eshazen/epic-control-panel/README.md

# epic-control-panel

Simple programmable controller for various applications in EPIC

KiCAD PCB design copied from SCOS project for BME research.

Applications:

* Wind tunnel controller for probe angle/height
