eshazen/epic-control-panel/Software/control-panel-blinky/README.md

# Keyboard / display / LED test

Test keyboard, display, LEDs
