eshazen/epic-control-panel/KiCAD/control-panel/3D/switch.step

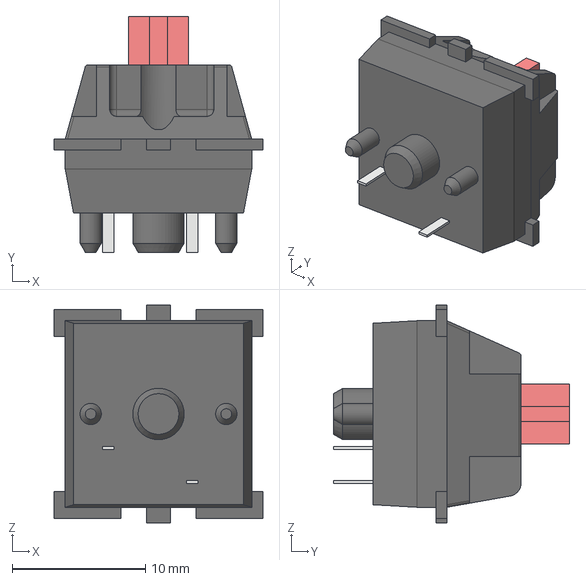
[picture p1: CAD file, 2024-07-23]
KiCAD/control-panel/3D/switch.step
15.6 x 17.7 x 16.3 mm
