eshazen/epic-control-panel/KiCAD/control-panel/control-panel.step

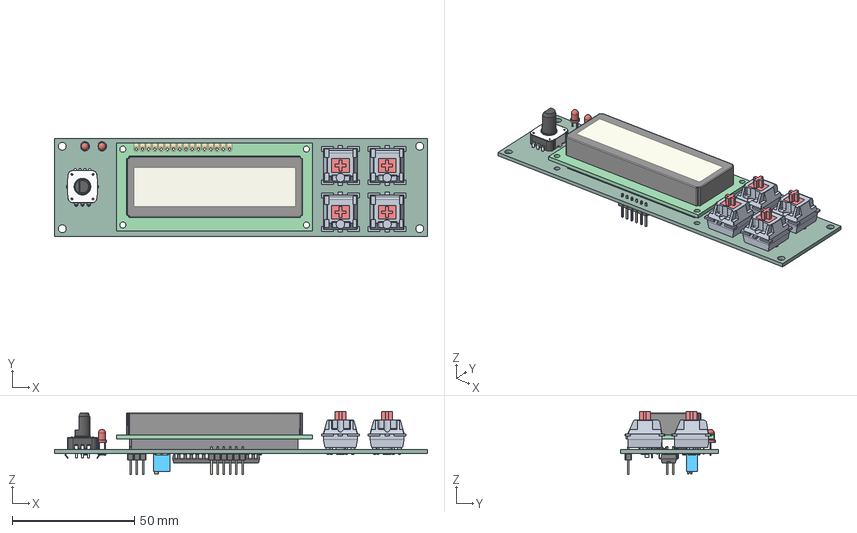
[picture p2: CAD file, 2024-07-25]
KiCAD/control-panel/control-panel.step
152.4 x 40.0 x 25.9 mm
cherry mx v28 x 4
EC12_10mm (3)
LED_D3.0mm x 2
Pad_001_sp
Potentiometer_Bourns_3266W_Vertical
R_1206_3216Metric x 6
PinHeader_1x06_P254mm_Vertical
PinHeader_2x03_P254mm_Vertical
C_1206_3216Metric
DIP-28_W7.62mm
control-panel_PCB
