eshazen/epic-control-panel/WindTunnel/Case/front_panel.dxf

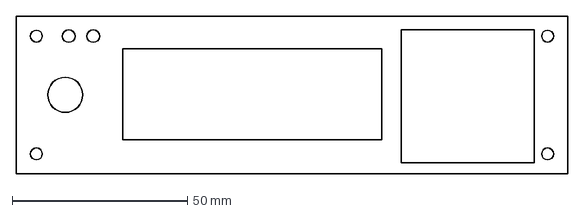
[picture p3: CAD file, 2024-07-25]
WindTunnel/Case/front_panel.dxf
157.4 x 45.0 mm
