eshazen/epic-control-panel/KiCAD/control-panel/3D/EC12 Encoder 10mm 3pin.stp

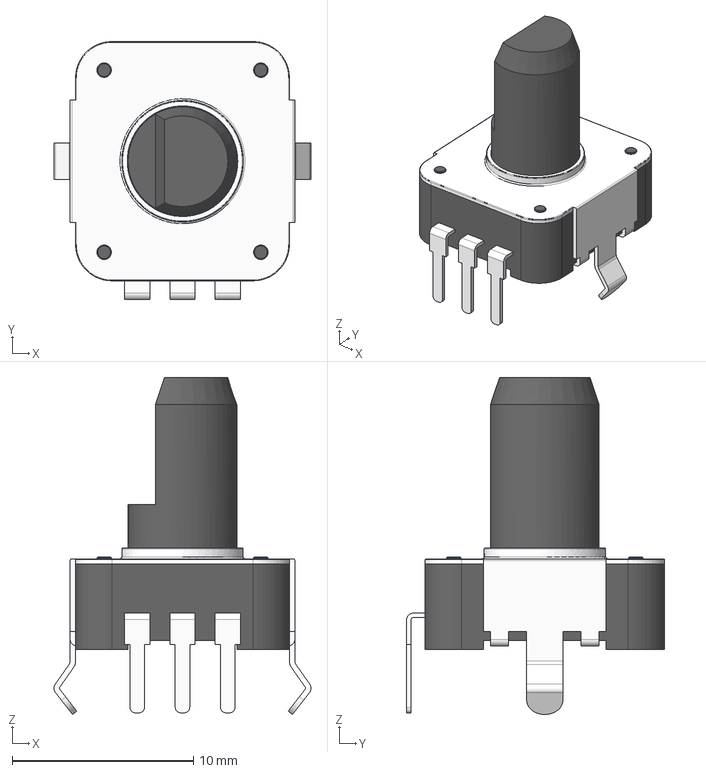
[picture p4: CAD file, 2024-07-23]
KiCAD/control-panel/3D/EC12 Encoder 10mm 3pin.stp
14.2 x 14.2 x 18.6 mm
