eshazen/epic-control-panel/(list of files, cad)

Other CAD files:
KiCAD/control-panel/3D/LCD_16x2_sparkfun.scad
