eshazen/epic-control-panel/WindTunnel/wiring-diagram/wiring-diagram.pdf

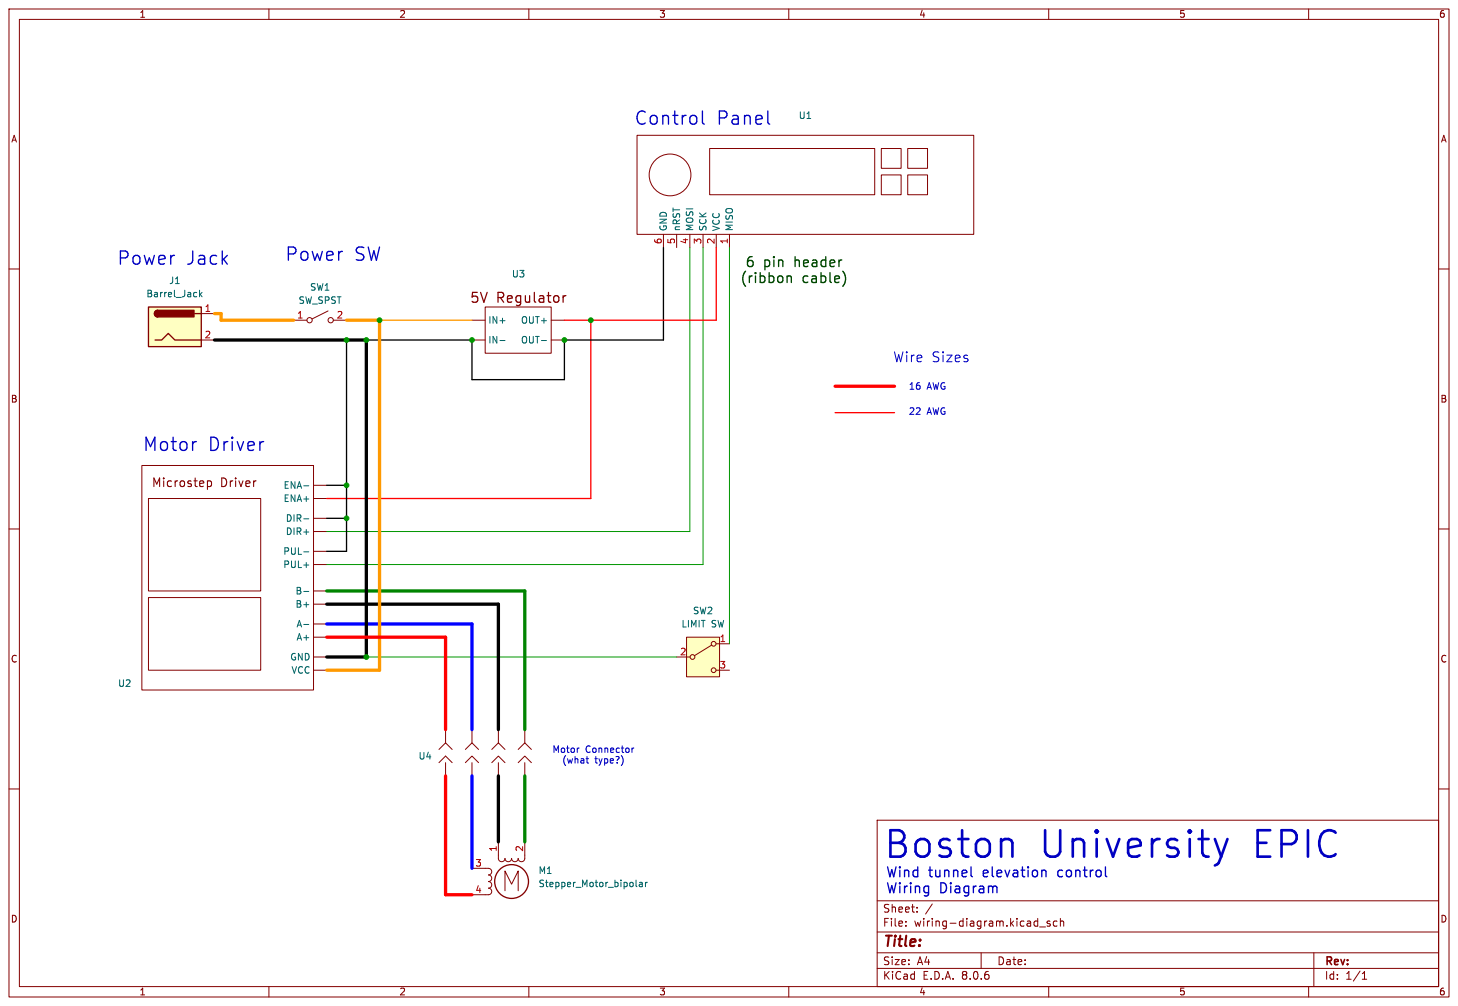
[picture p5: page 1]

(ribbon cable) Motor Connector

Id: 1/1 Title: File: wiring-diagram.kicad_sch Sheet: / 1
