eshazen/epic-control-panel/KiCAD/control-panel/control-panel.pdf

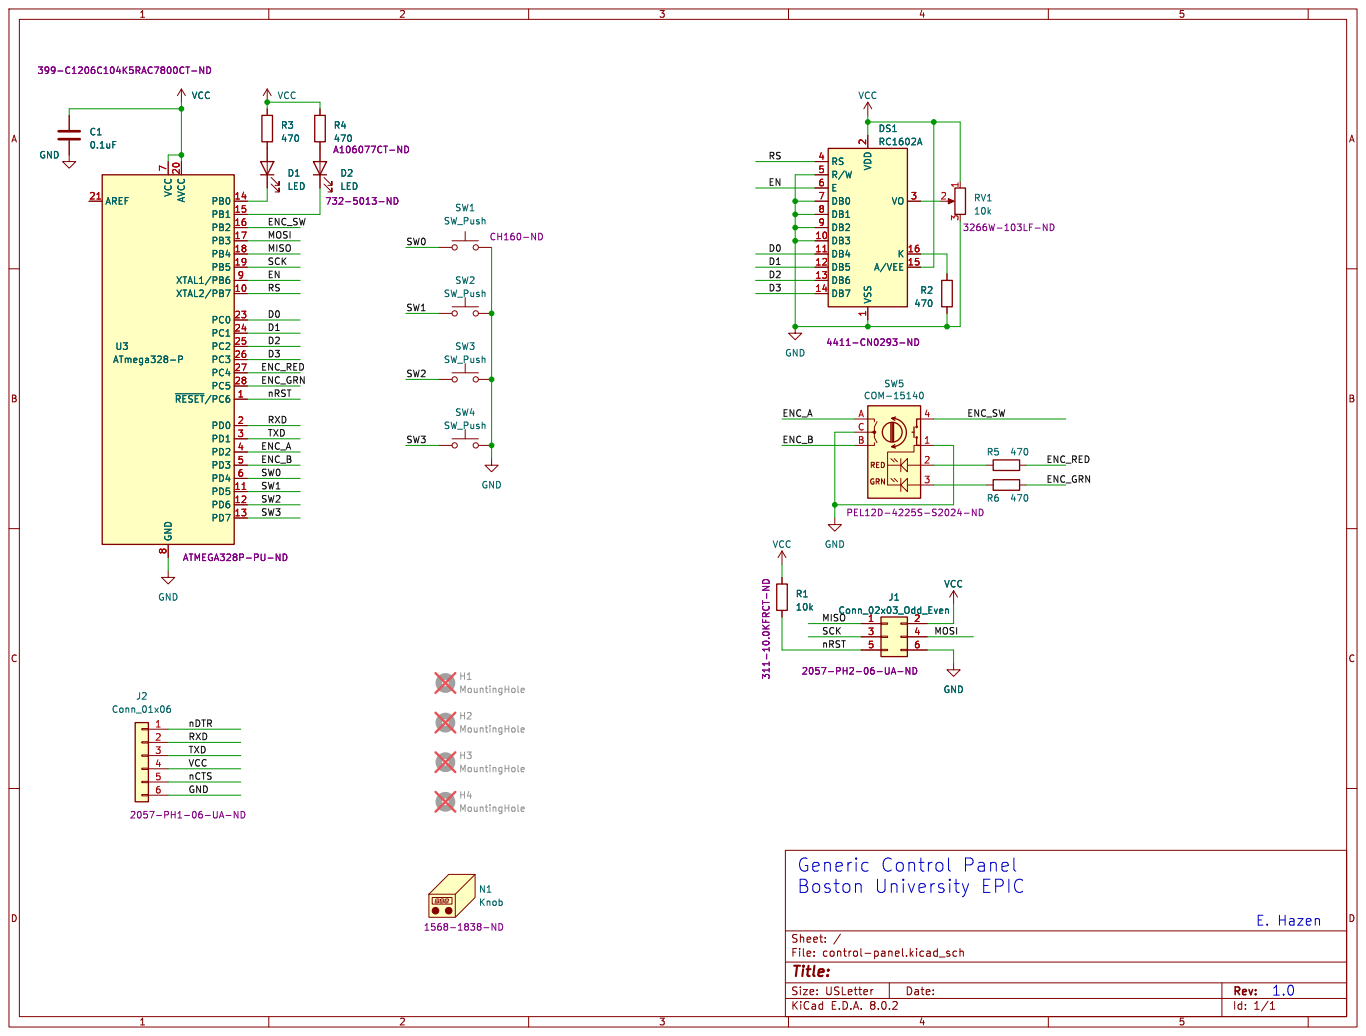
[picture p6: page 1]

H1 MountingHole H4 MountingHole H3 MountingHole H2 MountingHole N1Knob
