eshazen/epic-control-panel/WindTunnel/wiring-diagram/wiring-diagram.kicad_pcb

## KiCad design hackpad.kicad_sch

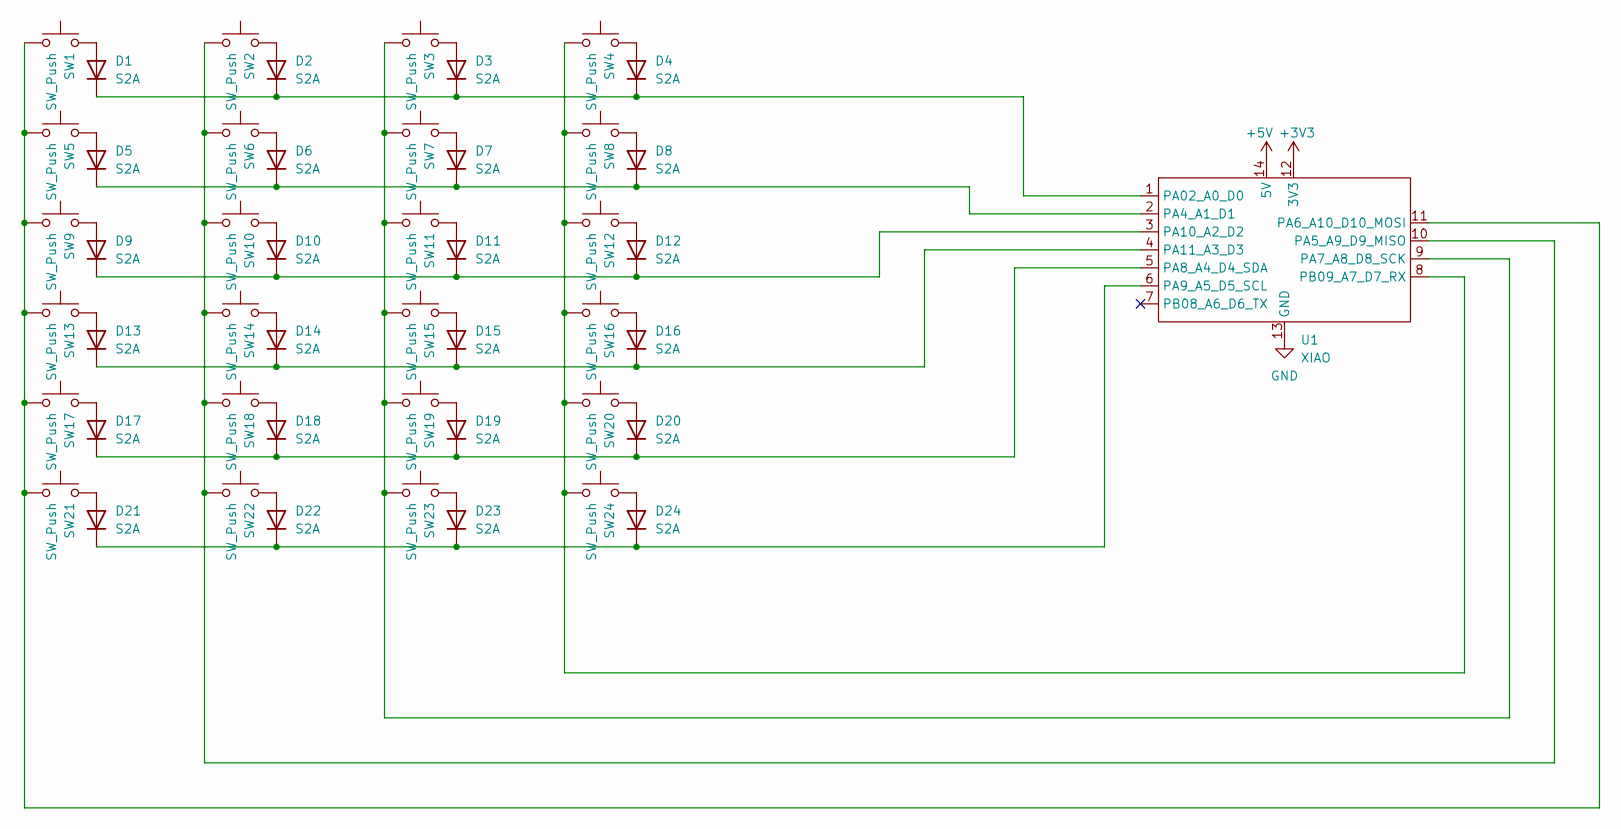
[picture p7: schematic hackpad.kicad_sch]

Parts:
D1, D2, D3, D4, D5, D6, D7, D8, D9, D10, D11, D12, D13, D14, D15, D16, D17, D18, D19, D20, D21, D22, D23, D24: S2A
SW1, SW2, SW3, SW4, SW5, SW6, SW7, SW8, SW9, SW10, SW11, SW12, SW13, SW14, SW15, SW16, SW17, SW18, SW19, SW20, SW21, SW22, SW23, SW24: SW_Push
U1: XIAO

Connections:
+3V3: U1.12 (3V3)
+5V: U1.14 (5V)
GND: U1.13 (GND)
unnamed: D1.1 (K), D2.1 (K), D3.1 (K), D4.1 (K), U1.1 (PA02_A0_D0)
unnamed: D1.2 (A), SW1.2
unnamed: D2.2 (A), SW2.2
unnamed: D3.2 (A), SW3.2
unnamed: D4.2 (A), SW4.2
unnamed: D5.1 (K), D6.1 (K), D7.1 (K), D8.1 (K), U1.2 (PA4_A1_D1)
unnamed: D5.2 (A), SW5.2
unnamed: D6.2 (A), SW6.2
unnamed: D7.2 (A), SW7.2
unnamed: D8.2 (A), SW8.2
unnamed: D9.2 (A), SW9.2
unnamed: D9.1 (K), D10.1 (K), D11.1 (K), D12.1 (K), U1.3 (PA10_A2_D2)
unnamed: D10.2 (A), SW10.2
unnamed: D11.2 (A), SW11.2
unnamed: D12.2 (A), SW12.2
unnamed: D13.1 (K), D14.1 (K), D15.1 (K), D16.1 (K), U1.4 (PA11_A3_D3)
unnamed: D13.2 (A), SW13.2
unnamed: D14.2 (A), SW14.2
unnamed: D15.2 (A), SW15.2
unnamed: D16.2 (A), SW16.2
unnamed: D17.1 (K), D18.1 (K), D19.1 (K), D20.1 (K), U1.5 (PA8_A4_D4_SDA)
unnamed: D17.2 (A), SW17.2
unnamed: D18.2 (A), SW18.2
unnamed: D19.2 (A), SW19.2
unnamed: D20.2 (A), SW20.2
unnamed: D21.1 (K), D22.1 (K), D23.1 (K), D24.1 (K), U1.6 (PA9_A5_D5_SCL)
unnamed: D21.2 (A), SW21.2
unnamed: D22.2 (A), SW22.2
unnamed: D23.2 (A), SW23.2
unnamed: D24.2 (A), SW24.2
unnamed: SW1.1, SW5.1, SW9.1, SW13.1, SW17.1, SW21.1, U1.11 (PA6_A10_D10_MOSI)
unnamed: SW2.1, SW6.1, SW10.1, SW14.1, SW18.1, SW22.1, U1.10 (PA5_A9_D9_MISO)
unnamed: SW3.1, SW7.1, SW11.1, SW15.1, SW19.1, SW23.1, U1.9 (PA7_A8_D8_SCK)
unnamed: SW4.1, SW8.1, SW12.1, SW16.1, SW20.1, SW24.1, U1.8 (PB09_A7_D7_RX)
