eshazen/epic-control-panel/Software/control-panel-blinky/uart.h

#include <avr/io.h>

#define USART_BAUDRATE 38400
#define UBRR_VALUE (((F_CPU / (USART_BAUDRATE * 16UL))) - 1)

void USART0Init(void);
int USART0SendByte(char u8Data, FILE *stream);
int USART0CharacterAvailable();
uint8_t USART0ReceiveByte();
void USART0GetString( char *buffer, int max);
void USART0SendString( char *string);
