eshazen/epic-control-panel/(commit log)

2024-07-23 Add control panel
    [Digikey-order-2024-05-16T135037.csv, EC12 Encoder 10mm 3pin.stp, LCD_16x2_sparkfun.scad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]
2024-07-25 Add front panel DXF for control panel
    [front_panel.dxf]
2024-07-25 Add step of control panel
    [control-panel.step]
2024-07-30 Update README with wiring
2024-07-30 initial motor control test software
2024-10-09 add wiring diagram
    [wiring-diagram.kicad_pcb, wiring-diagram.kicad_sch]
2024-10-09 final wiring diagram
    [wiring-diagram.kicad_sch]
2024-10-22 update wiring diagram pdf
2024-10-22 Move stepping motor demo to own folder, restore control-panel-test
2024-10-23 starting WT framework, 1ms timer test
2024-10-30 README, working UP/DOWN test run motor
2024-10-30 full test display / keys / LEDs / motor
